felixd1900/TPSensor/Receiver/PCB_Full/Assembly/TPSensor-BOM.csv

Comment | Designator | Footprint | LCSC
100nF | C1 | Capacitor_SMD:C_0402_1005Metric | C1525
100nF | C2 | Capacitor_SMD:C_0402_1005Metric | C1525
100nF | C3 | Capacitor_SMD:C_0402_1005Metric | C1525
100nF | C4 | Capacitor_SMD:C_0402_1005Metric | C1525
10uF | C5 | Capacitor_SMD:C_1206_3216Metric | C13585
100nF | C6 | Capacitor_SMD:C_0402_1005Metric | C1525
100nF | C7 | Capacitor_SMD:C_0402_1005Metric | C1525
100nF | C8 | Capacitor_SMD:C_0402_1005Metric | C1525
1uF | C9 | Capacitor_SMD:C_0402_1005Metric | C52923
10pF | C10 | Capacitor_SMD:C_0402_1005Metric | C32949
10pF | C11 | Capacitor_SMD:C_0402_1005Metric | C32949
100nF | C12 | Capacitor_SMD:C_0402_1005Metric | C1525
22uF | C13 | Capacitor_SMD:C_1206_3216Metric | C12891
100nF | C14 | Capacitor_SMD:C_0402_1005Metric | C1525
100nF | C15 | Capacitor_SMD:C_0402_1005Metric | C1525
10uF | C16 | Capacitor_SMD:C_1206_3216Metric | C13585
1uF | C17 | Capacitor_SMD:C_0402_1005Metric | C52923
100nF | C18 | Capacitor_SMD:C_0402_1005Metric | C1525
100nF | C19 | Capacitor_SMD:C_0402_1005Metric | C1525
22uF | C20 | Capacitor_SMD:C_1206_3216Metric | C12891
100nF | C51 | Capacitor_SMD:C_0402_1005Metric | C1525
10pF | C81 | Capacitor_SMD:C_0402_1005Metric | C32949
10pF | C101 | Capacitor_SMD:C_0402_1005Metric | C32949
3.9pF | C121 | Capacitor_SMD:C_0402_1005Metric | C1566
8.2pF | C122 | Capacitor_SMD:C_0402_1005Metric | C1579
5.6pF | C123 | Capacitor_SMD:C_0402_1005Metric | C1574
220pF | C124 | Capacitor_SMD:C_0402_1005Metric | C1530
220pF | C125 | Capacitor_SMD:C_0402_1005Metric | C1530
3.9pF | C131 | Capacitor_SMD:C_0402_1005Metric | C1566
LED | D1 | LED_SMD:LED_0603_1608Metric | C2286
LED | D2 | LED_SMD:LED_0603_1608Metric | C2286
SWD_Connector | J1 | Connector_PinHeader_1.27mm:PinHeader_2x05_P1.27mm_Vertical
USB_B_Micro | J2 | Connector_USB:USB_Micro-B_Molex-105017-0001 | C136000
Conn_01x03 (Boot Jumper) | J4 | Connector_PinHeader_2.54mm:PinHeader_1x03_P2.54mm_Vertical
SPI_Conn_01x04 (SPI) | J6 | Connector_PinHeader_2.54mm:PinHeader_1x04_P2.54mm_Vertical
Conn_01x03 (Power Jumper) | J7 | Connector_PinHeader_2.54mm:PinHeader_1x03_P2.54mm_Vertical
Screw_Terminal_01x02 (3.3V) | J8 | TerminalBlock_Phoenix:TerminalBlock_Phoenix_MKDS-3-2-5.08_1x02_P5.08mm_Horizontal
Conn_Coaxial | J9 | Connector_Coaxial:SMA_Amphenol_901-143_Horizontal | C496551
ABP2Conn_01x05 | J10 | Connector_PinHeader_2.54mm:PinHeader_1x05_P2.54mm_Vertical
39nH | L2 | Inductor_SMD:L_0402_1005Metric | C26443
27nH | L121 | Inductor_SMD:L_0402_1005Metric | C18830
22nH | L122 | Inductor_SMD:L_0402_1005Metric | C86129
27nH | L123 | Inductor_SMD:L_0402_1005Metric | C18830
27nH | L131 | Inductor_SMD:L_0402_1005Metric | C18830
10k | R2 | Resistor_SMD:R_0402_1005Metric | C25744
47 | R3 | Resistor_SMD:R_0603_1608Metric | C23182
680 | R4 | Resistor_SMD:R_0603_1608Metric | C23228
47 | R6 | Resistor_SMD:R_0603_1608Metric | C23182
680 | R7 | Resistor_SMD:R_0603_1608Metric | C23228
10k | R8 | Resistor_SMD:R_0402_1005Metric | C25744
10k | R9 | Resistor_SMD:R_0402_1005Metric | C25744
56k | R171 | Resistor_SMD:R_0603_1608Metric | C23206
USBLC6-2SC6 | U1 | Package_TO_SOT_SMD:SOT-23-6 | C7519
CC1101RGPR | U3 | CC1101RGPR:RGP20_2P4X2P4 | C29953
STM32L052C8Tx | U4 | Package_QFP:LQFP-48_7x7mm_P0.5mm | C111213
AMS1117-3.3 | U5 | Package_TO_SOT_SMD:SOT-223 | C347222
26MHz | Y1 | Crystal:Crystal_SMD_3225-4Pin_3.2x2.5mm | C15192
16MHz | Y2 | Crystal:Crystal_SMD_3225-4Pin_3.2x2.5mm | C13738
