felixd1900/TPSensor/General/Pinout_Debug.xlsx

gnd | schwarz
swclk | blau
rst | weiss
swdio | grün
3.3v | rot
swo | gelb
