felixd1900/TPSensor/Receiver/PCB_Full/Schematic.pdf

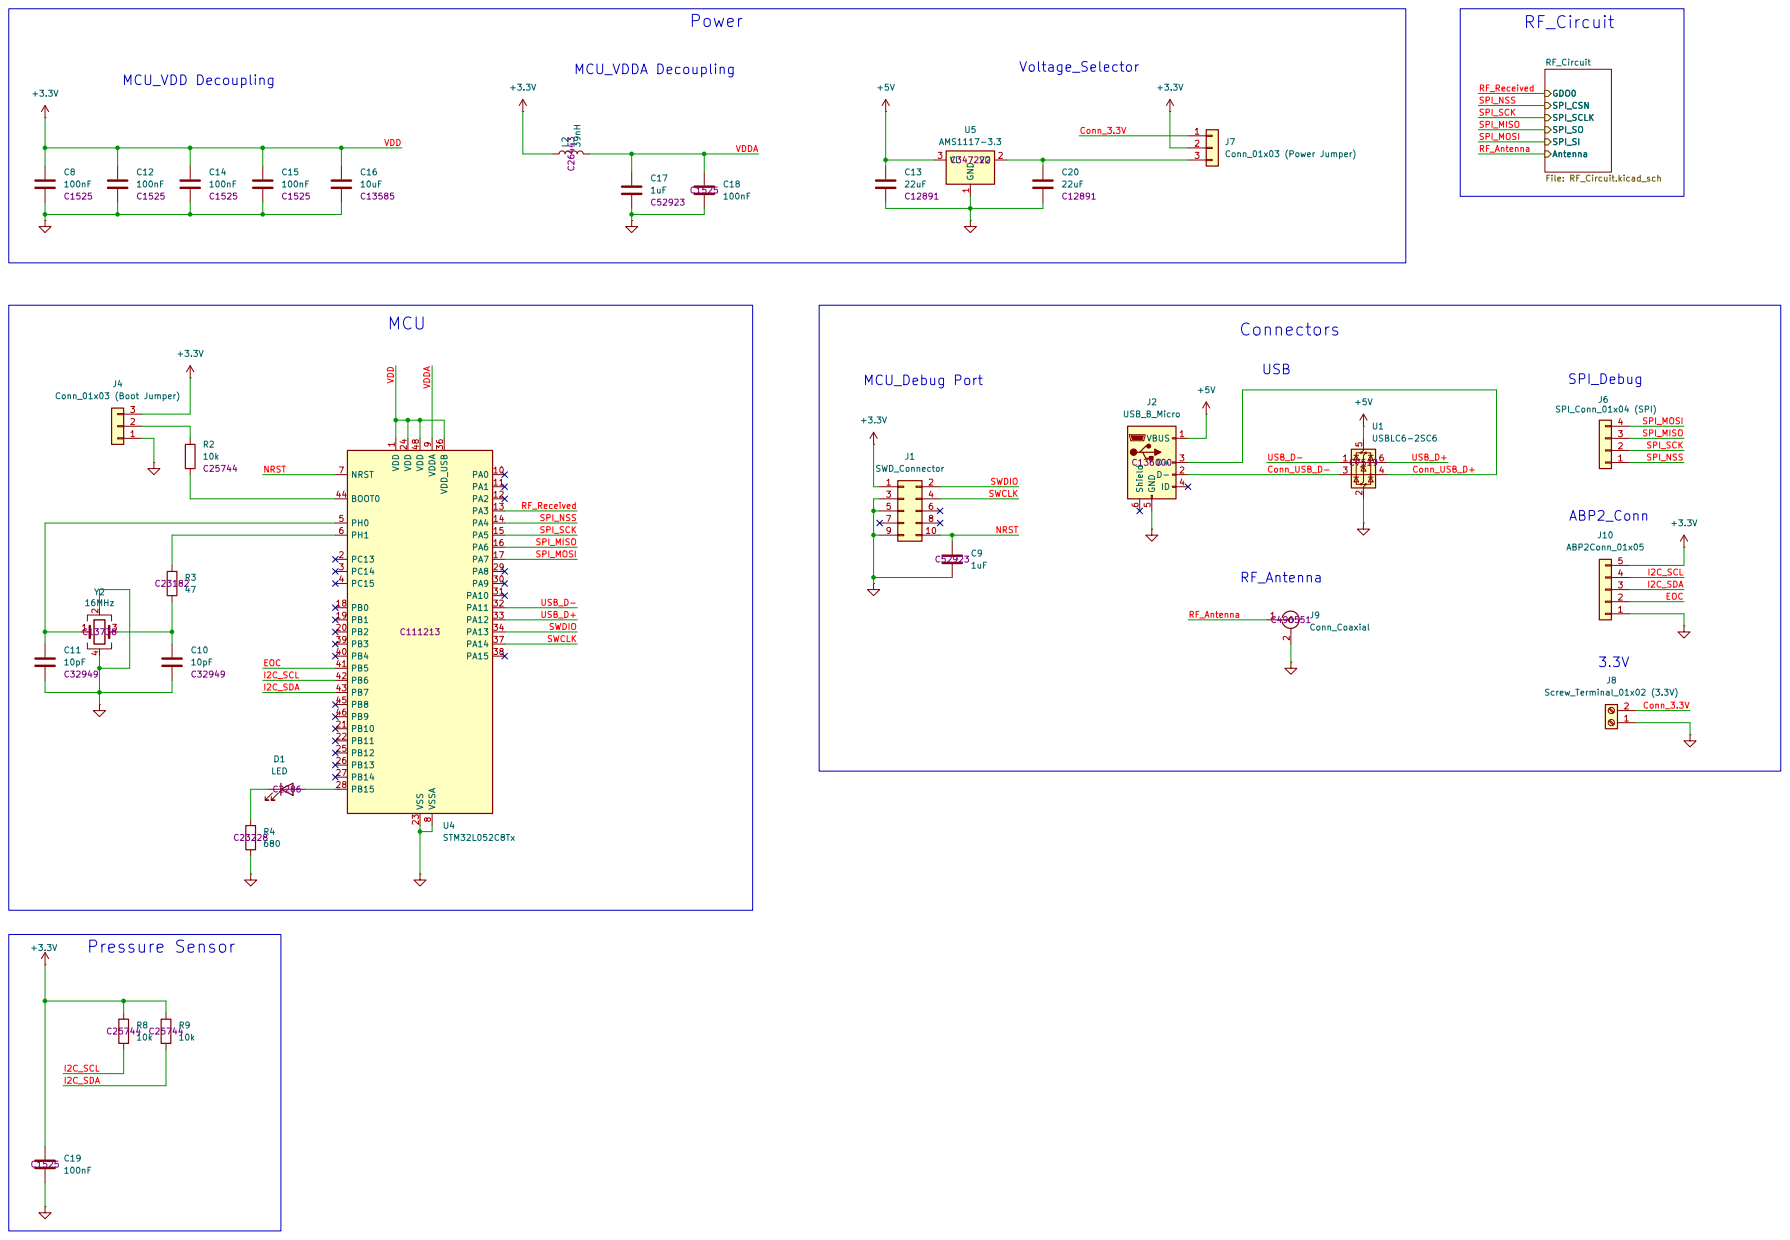
[picture p1: page 1]

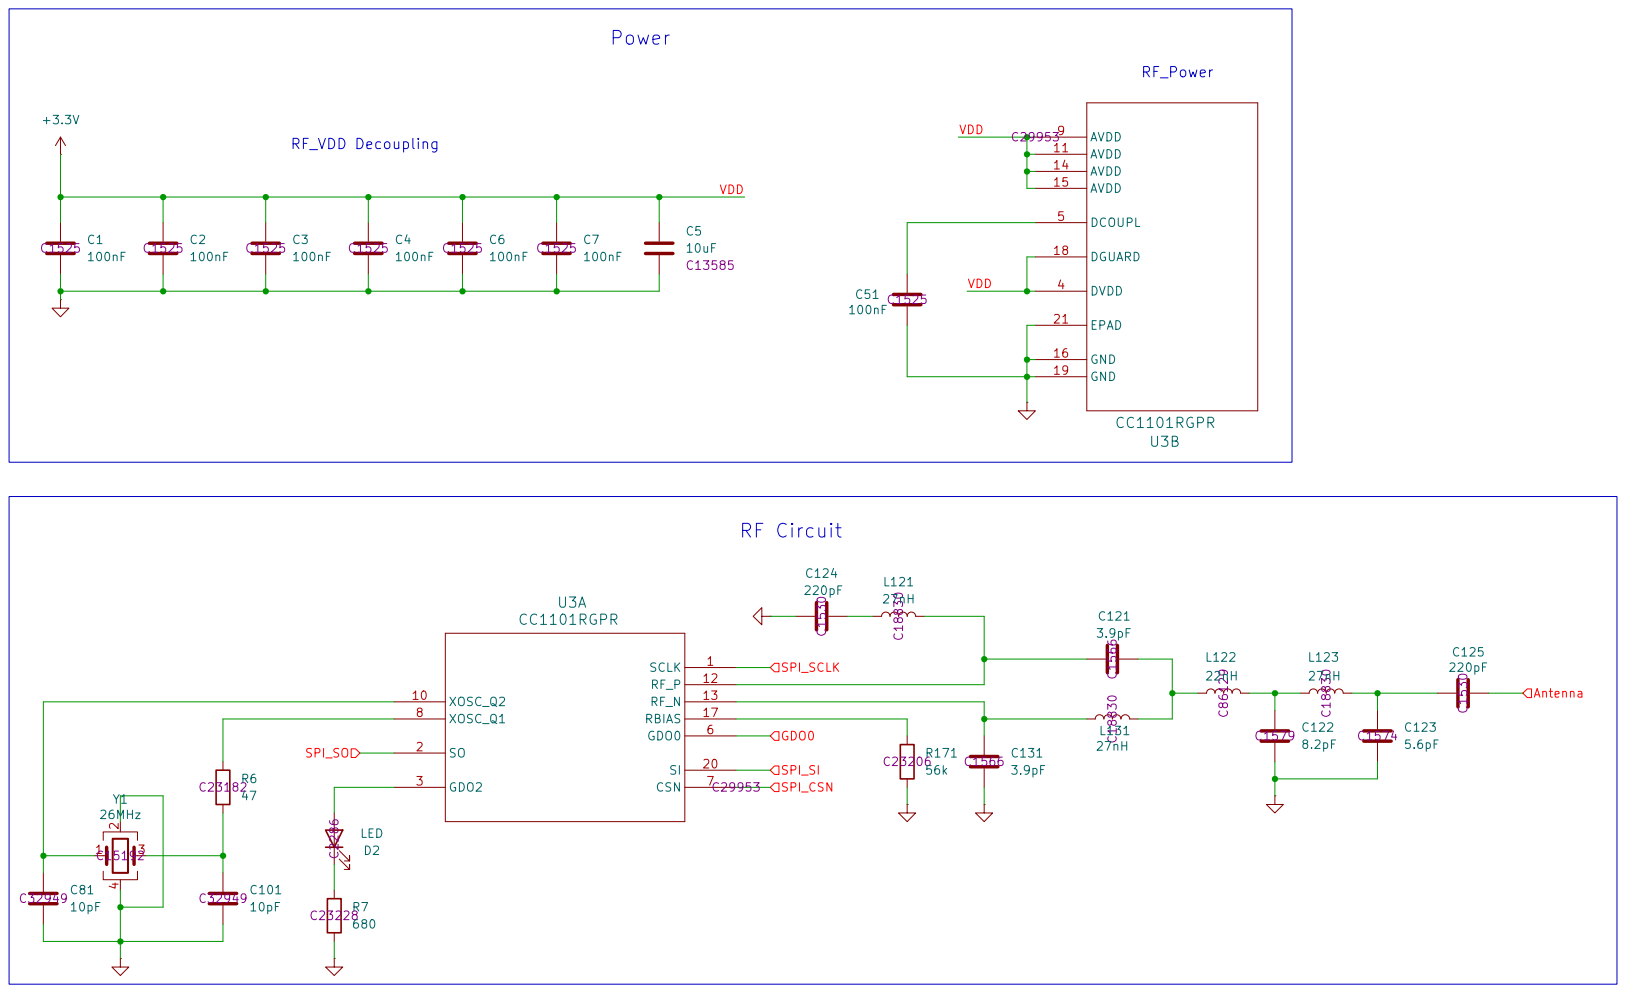
[picture p2: page 2]
