felixd1900/TPSensor/Receiver/PCB_Full/Receiver.kicad_pcb

## KiCad design Receiver/PCB_Full/Receiver.kicad_pcb (2025-09-05)

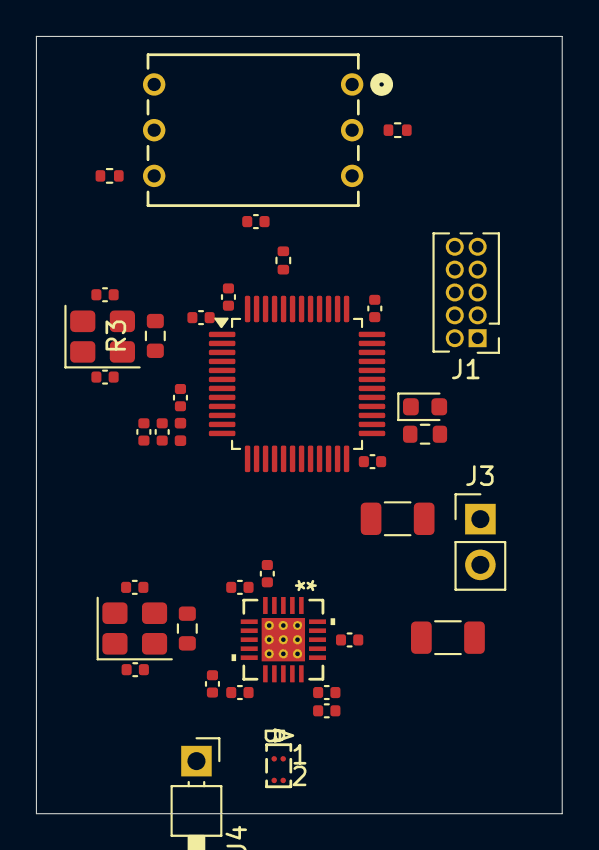
[picture p3: board Receiver.kicad_pcb from above]

Board: 4 copper layers, 29.2 x 43.2 mm, 38 parts (0 on the bottom side), 27 nets, no tracks yet.

Parts:
C1, C2, C3, C4, C6, C7, C8, C12, C14, C15, C18, C19, C51: 100nF; C_0402_1005Metric
C5, C16: 10uF; C_1206_3216Metric
C9, C17: 1uF; C_0402_1005Metric
C10, C11, C81, C101: 10pF; C_0402_1005Metric
D1: LED; LED_0603_1608Metric
J1: SWD_Connector; PinHeader_2x05_P1.27mm_Vertical
J3: Power_Connector; PinHeader_1x02_P2.54mm_Vertical
J4: Antenna_Connector; PinHeader_1x01_P2.54mm_Horizontal
L2: 39nH; L_0402_1005Metric
R2, R8, R9: 10k; R_0402_1005Metric
R3, R6: 47; R_0603_1608Metric
R4: 680; R_0603_1608Metric
U2: BAL-CC1101-01D3; BGA_01-01D3_STM
U3: CC1101RGPR; RGP20_2P4X2P4
U4: STM32L052C8Tx; LQFP-48_7x7mm_P0.5mm
U6: ABP2DANT001PG2A3XX; ABP2DANT&slash_G_HNW
Y1: 26MHz; Crystal_SMD_3225-4Pin_3.2x2.5mm
Y2: 16MHz; Crystal_SMD_3225-4Pin_3.2x2.5mm

Connections:
+3.3V: C1.1, C2.1, C3.1, C4.1, C5.1, C6.1, C7.1, C8.1, C12.1, C14.1, C15.1, C16.1, C19.1, J1.1, J3.2, L2.1, R8.1, R9.1, U3.4 (DVDD), U3.9 (AVDD), U3.11 (AVDD), U3.14 (AVDD), U3.15 (AVDD), U3.18 (DGUARD), U4.1 (VDD), U4.24 (VDD), U4.36 (VDD_USB), U4.48 (VDD), U6.1 (VDD)
/EOC: U4.41 (PB5), U6.3 (EOC)
/I2C_SCL: R8.2, U4.42 (PB6), U6.2 (SCL)
/I2C_SDA: R9.2, U4.43 (PB7), U6.4 (SDA)
/NRST: C9.1, J1.10, U4.7 (NRST)
/RF_Antenna: J4.1, U2.A1 (SE)
/RF_Received: U3.6 (GDO0), U4.13 (PA3)
/SPI_MISO: U3.2 (SO), U4.16 (PA6)
/SPI_MOSI: U3.20 (SI), U4.17 (PA7)
/SPI_NSS: U3.7 (CSN), U4.14 (PA4)
/SPI_SCK: U3.1 (SCLK), U4.15 (PA5)
/SWCLK: J1.4, U4.37 (PA14)
/SWDIO: J1.2, U4.34 (PA13)
/VDDA: C17.1, C18.1, L2.2, U4.9 (VDDA)
GND: C1.2, C2.2, C3.2, C4.2, C5.2, C6.2, C7.2, C8.2, C9.2, C10.2, C11.2, C12.2, C14.2, C15.2, C16.2, C17.2, C18.2, C19.2, C51.2, C81.2, C101.2, J1.3, J1.5, J1.9, J3.1, R2.2, R4.2, U2.B1 (GND), U3.16 (GND), U3.19 (GND), U3.21 (EPAD), U4.8 (VSSA), U4.23 (VSS), U4.35 (VSS), U4.47 (VSS), U6.5 (GND), Y1.2, Y1.4, Y2.2, Y2.4
unnamed: C10.1, R3.2, Y2.3
unnamed: C101.1, R6.2, Y1.3
unnamed: D1.2 (A), U4.28 (PB15)
unnamed: D1.1 (K), R4.1
unnamed: U2.A2 (DIFF), U3.13 (RF_N)
unnamed: U2.B2 (DIFF), U3.12 (RF_P)
unnamed: R6.1, U3.8 (XOSC_Q1)
unnamed: C81.1, U3.10 (XOSC_Q2), Y1.1
unnamed: C51.1, U3.5 (DCOUPL)
unnamed: R2.1, U4.44 (BOOT0)
unnamed: C11.1, U4.5 (PH0), Y2.1
unnamed: R3.1, U4.6 (PH1)
