felixd1900/TPSensor/TyrePressure/PCB_Dev/TPSensor.kicad_pcb

## KiCad design TyrePressure/PCB_Dev/TPSensor.kicad_pcb (2025-08-05)

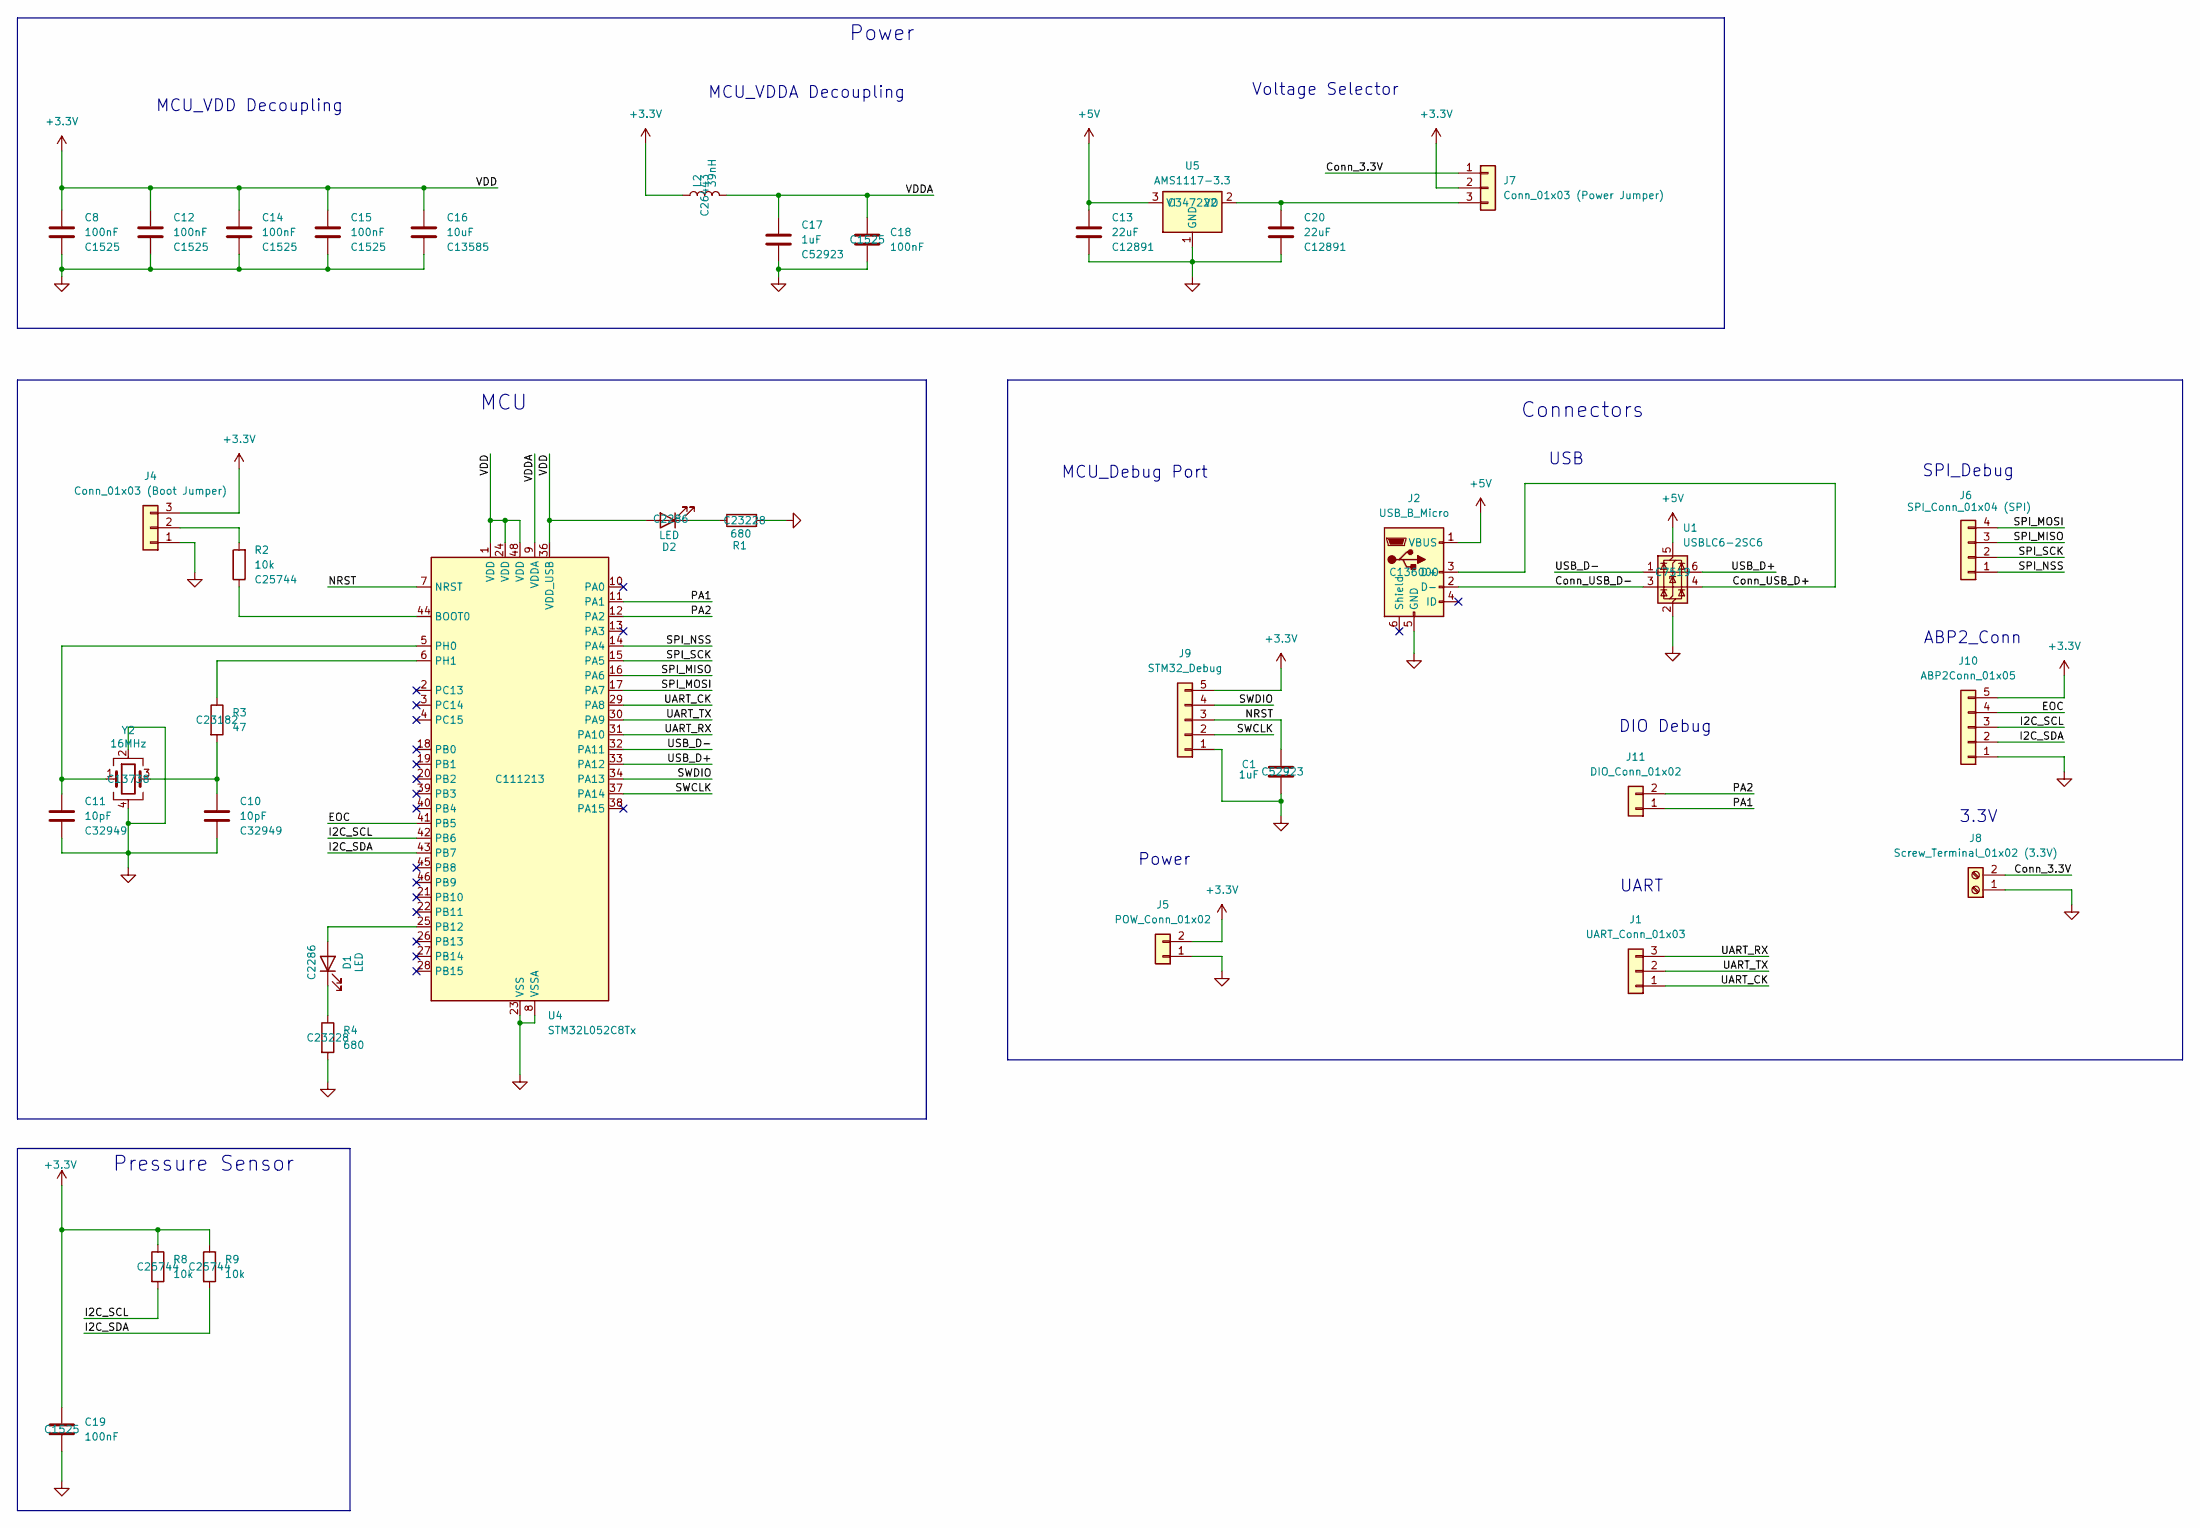
[picture p4: schematic TPSensor.kicad_sch]

Parts:
C1, C17: 1uF; C_0402_1005Metric; LCSC C52923
C8, C12, C14, C15, C18, C19: 100nF; C_0402_1005Metric; LCSC C1525
C10, C11: 10pF; C_0402_1005Metric; LCSC C32949
C13, C20: 22uF; C_1206_3216Metric; LCSC C12891
C16: 10uF; C_1206_3216Metric; LCSC C13585
D1, D2: LED; LED_0603_1608Metric; LCSC C2286
J1: UART_Conn_01x03; PinHeader_1x03_P2.54mm_Vertical
J2: USB_B_Micro; USB_Micro-B_Molex-105017-0001; LCSC C136000
J4: Conn_01x03 (Boot Jumper); PinHeader_1x03_P2.54mm_Vertical
J5: POW_Conn_01x02; PinHeader_1x02_P2.54mm_Vertical
J6: SPI_Conn_01x04 (SPI); PinHeader_1x04_P2.54mm_Vertical
J7: Conn_01x03 (Power Jumper); PinHeader_1x03_P2.54mm_Vertical
J8: Screw_Terminal_01x02 (3.3V); TerminalBlock_Phoenix_MKDS-3-2-5.08_1x02_P5.08mm_Horizontal
J9: STM32_Debug; PinHeader_1x05_P2.54mm_Vertical
J10: ABP2Conn_01x05; PinHeader_1x05_P2.54mm_Vertical
J11: DIO_Conn_01x02; PinHeader_1x02_P2.54mm_Vertical
L2: 39nH; L_0402_1005Metric; LCSC C26443
R1, R4: 680; R_0603_1608Metric; LCSC C23228
R2, R8, R9: 10k; R_0402_1005Metric; LCSC C25744
R3: 47; R_0603_1608Metric; LCSC C23182
U1: USBLC6-2SC6; SOT-23-6; LCSC C7519
U4: STM32L052C8Tx; LQFP-48_7x7mm_P0.5mm; LCSC C111213
U5: AMS1117-3.3; SOT-223; LCSC C347222
Y2: 16MHz; Crystal_SMD_3225-4Pin_3.2x2.5mm; LCSC C13738

Connections:
+3.3V: C8.1, C12.1, C14.1, C15.1, C16.1, C19.1, D2.2 (A), J4.3, J5.2, J7.2, J9.5, J10.5, L2.1, R8.1, R9.1, U4.1 (VDD), U4.24 (VDD), U4.36 (VDD_USB), U4.48 (VDD)
+5V: C13.1, J2.1 (VBUS), U1.5 (VBUS), U5.3 (VI)
/Conn_3.3V: J7.1, J8.2
/Conn_USB_D+: J2.3 (D+), U1.4 (I/O2)
/Conn_USB_D-: J2.2 (D-), U1.3 (I/O2)
/EOC: J10.4, U4.41 (PB5)
/I2C_SCL: J10.3, R8.2, U4.42 (PB6)
/I2C_SDA: J10.2, R9.2, U4.43 (PB7)
/NRST: C1.1, J9.3, U4.7 (NRST)
/PA1: J11.1, U4.11 (PA1)
/PA2: J11.2, U4.12 (PA2)
/SPI_MISO: J6.3, U4.16 (PA6)
/SPI_MOSI: J6.4, U4.17 (PA7)
/SPI_NSS: J6.1, U4.14 (PA4)
/SPI_SCK: J6.2, U4.15 (PA5)
/SWCLK: J9.2, U4.37 (PA14)
/SWDIO: J9.4, U4.34 (PA13)
/UART_CK: J1.1, U4.29 (PA8)
/UART_RX: J1.3, U4.31 (PA10)
/UART_TX: J1.2, U4.30 (PA9)
/USB_D+: U1.6 (I/O1), U4.33 (PA12)
/USB_D-: U1.1 (I/O1), U4.32 (PA11)
/VDDA: C17.1, C18.1, L2.2, U4.9 (VDDA)
GND: C1.2, C8.2, C10.2, C11.2, C12.2, C13.2, C14.2, C15.2, C16.2, C17.2, C18.2, C19.2, C20.2, J2.5 (GND), J4.1, J5.1, J8.1, J9.1, J10.1, R1.2, R4.2, U1.2 (GND), U4.8 (VSSA), U4.23 (VSS), U4.35 (VSS), U4.47 (VSS), U5.1 (GND), Y2.2, Y2.4
unnamed: C10.1, R3.2, Y2.3
unnamed: D1.2 (A), U4.25 (PB12)
unnamed: D1.1 (K), R4.1
unnamed: D2.1 (K), R1.1
unnamed: J4.2, R2.2
unnamed: C20.1, J7.3, U5.2 (VO)
unnamed: R2.1, U4.44 (BOOT0)
unnamed: C11.1, U4.5 (PH0), Y2.1
unnamed: R3.1, U4.6 (PH1)

Notes on the sheet:
3.3V
MCU_VDDA Decoupling
ABP2_Conn
UART
DIO Debug
Voltage Selector
SPI_Debug
MCU_VDD Decoupling
Power
MCU
Pressure Sensor
Connectors
USB
MCU_Debug Port

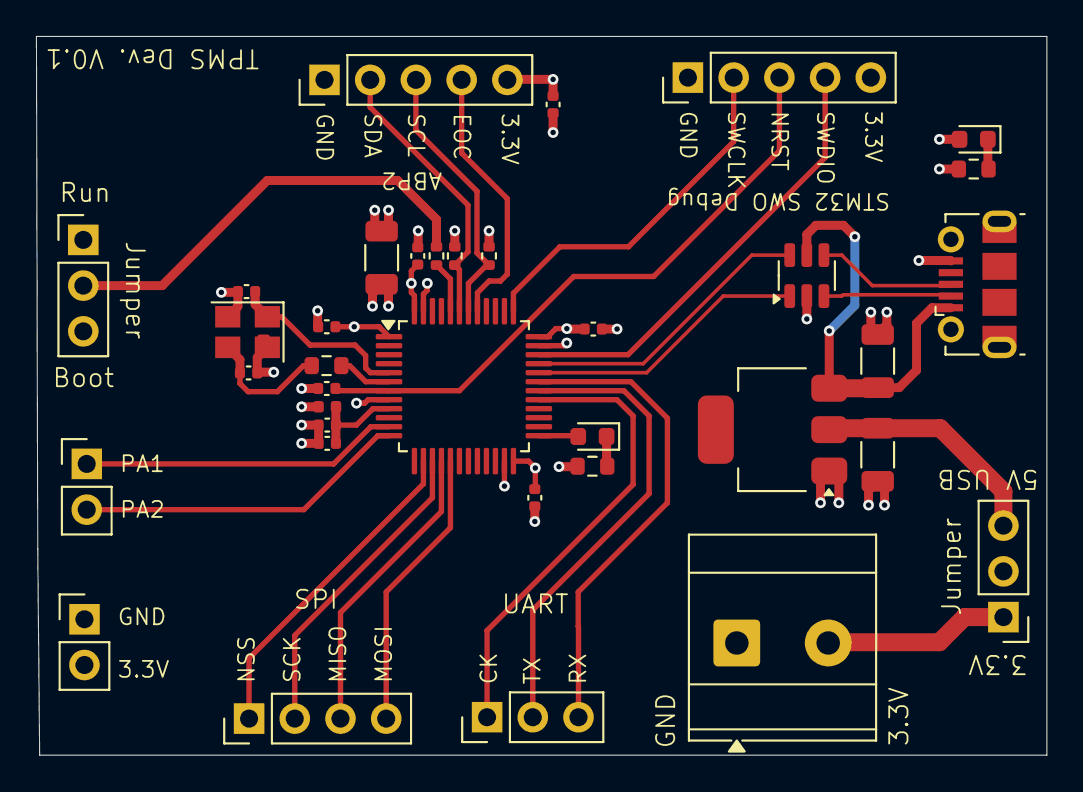
[picture p5: board TPSensor.kicad_pcb from above]

Board: 4 copper layers, 56.1 x 39.9 mm, 36 parts (0 on the bottom side), 33 nets.
