felixd1900/TPSensor/TyrePressure/Software/TPSensor/Core/Src/main.c

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
/* Includes ------------------------------------------------------------------*/
#include "main.h"

/* USER CODE BEGIN Includes */
#include "string.h"
#include "math.h"
#include "type_conv.h"
#include "abp2.h"
#include "cc1101.h"
/* USER CODE END Includes */

/* USER CODE BEGIN PTD */

//address offset in eeprom
typedef enum {
	// U8 Values
	EE_ADDR_SENSOR_ID = 			0x00,
	EE_ADDR_SENSOR_TYPE = 			0x01,
	// U32 Values
	EE_ADDR_STORAGE_SAMPLE =		0x10,
	EE_ADDR_TRANS_SAMPLE =			0x14,
	EE_ADDR_TRANS_TX =				0x18,
	EE_ADDR_STATIC_SAMPLE =			0x1C,
	EE_ADDR_STATIC_TX =				0x20,
	// float
	EE_ADDR_THRESH1 =				0x30,
	EE_ADDR_THRESH2 =				0x34,
	EE_ADDR_CHANGE =				0x38
}ee_offset_t;

typedef enum {
	PRO_MODE_OPERATION = 		0x01,
	PRO_MODE_PROGRAMMING = 		0x02
} pro_mode_t;

typedef enum {
	PRO_CMD_SENSOR_ID = 				0x01,
	PRO_CMD_SENSOR_TYPE = 				0x02,
	PRO_CMD_STORAGE_SAMPLE = 			0x10,
	PRO_CMD_TRANS_SAMPLE = 				0x11,
	PRO_CMD_TRANS_TX = 					0x12,
	PRO_CMD_STATIC_SAMPLE = 			0x13,
	PRO_CMD_STATIC_TX = 				0x14,
	PRO_CMD_PRESS_THRESH1 = 			0x20,
	PRO_CMD_PRESS_THRESH2 = 			0x21,
	PRO_CMD_PRESS_THRESH_CHANGE = 		0x22,
	PRO_CMD_READ_ALL =					0x50
} pro_cmd_t;

typedef enum {
	OP_MODE_STORAGE = 			0x01,
	OP_MODE_TRANSIENT = 		0x02,
	OP_MODE_STATIC =			0x03
} op_mode_t;

typedef struct {
	uint8_t sensorid;						//this is the default sensorid the current id is stored in eeprom
	uint8_t sensortype;						//0x01 = tyre pressure | 0x02 = brake disk pressure (to be implemented)
	uint32_t storage_time_sample;			//sample rate tx (ms) in transient mode
	uint32_t trans_time_tx;					//sample rate tx (ms) in transient mode
	uint32_t trans_time_sample;				//sample rate abp2 read (ms) in transient mode
	uint32_t static_time_tx;				//sample rate tx (ms) in transient mode
	uint32_t static_time_sample;			//sample rate abp2 read (ms) in transient mode
	float trans_press_thresh1;				//move from storage into transient mode
	float trans_press_thresh2;				//move from transient mode into storage mode
	float trans_press_change;				//minimum pressure change to move to transient mode
}eeprom_conf_t;


typedef struct {
    float y;            // filtered value
    float alpha;        // smaller value -> more smoothing
} ema_t;


/* USER CODE END PTD */

/* USER CODE BEGIN PD */

#define ABP2_I2C_ID				0x28
#define TX_FIFO_EEPROM_LEN		36
#define TX_FIFO_DATA_LEN		14
#define RX_FIFO_EEPROM_LEN		7		// cmd, uint32 data, lqi, rssi
#define RESPONSE_DELAY 			100		// delay in ms when responding to request (wait for other CC1101 to settle in RX)

/* USER CODE END PD */

I2C_HandleTypeDef hi2c1;

RTC_HandleTypeDef hrtc;

SPI_HandleTypeDef hspi1;

TIM_HandleTypeDef htim21;
TIM_HandleTypeDef htim22;

/* USER CODE BEGIN PV */

//===========Programmable variables========
eeprom_conf_t eeprom_conf = {
    .sensorid            = 0x10,
    .sensortype          = 0x01,   // 0x01 = tyre pressure
    .storage_time_sample = 5000,
    .trans_time_tx       = 1000,
    .trans_time_sample   = 100,
    .static_time_tx      = 10000,
    .static_time_sample  = 100,
    .trans_press_thresh1 = 0.6f,
    .trans_press_thresh2 = 0.5f,
    .trans_press_change  = 0.0f,
};

//==============Gereral variables==========
pro_mode_t programming_mode = PRO_MODE_OPERATION;
op_mode_t operational_mode = OP_MODE_TRANSIENT;
op_mode_t operational_mode_old = OP_MODE_TRANSIENT;
bool pro_mode_changed = false;
bool op_mode_changed = false;
ema_t ema_pressure = {0, 0.5};
ema_t ema_temperature = {20, 0.5};

//==============ABP2 Variables=============
abp2_t abp2;
float abp2_pressure = 0.0f;
float abp2_pressure_change = 0.0f;
float abp2_temperature = 0.0f;
abp2_status abp2status;
uint8_t abp2status_raw = 0;
bool abp2_sample_ready = false;
uint32_t abp2_sample_timer = 100;


//============CC1101 TX Variables==========
cc1101_t cc1101;
uint8_t tx_fifo_eeprom[TX_FIFO_EEPROM_LEN] = {};
uint8_t tx_fifo_data[TX_FIFO_DATA_LEN] = {};
uint8_t debug_tx_counter = 0;
cc1101_marc_state marcstate = CC1101_MARC_SLEEP;
bool Init_complete = false;
uint32_t tx_duration = 0;
bool tx_ready = false;
uint32_t tx_timer = 1000;


//============CC1101 RX variables==========
uint8_t rx_bytes = 0x00;
uint8_t rx[RX_FIFO_EEPROM_LEN] = {0};
bool rx_received = false;
uint8_t rx_length = 0x00;

//=============Debug variables=============
uint8_t debug_status_part = 0;
uint8_t debug_status_ver = 0;
uint8_t debug_reg_all_before[46] = {0};
uint8_t debug_reg_all_after[46] = {0};
cc1101_tx_power cc1101_power_ramp[8] = {CC1101_TX_M30dB, CC1101_TX_M20dB, CC1101_TX_M15dB, CC1101_TX_M10dB, CC1101_TX_0dB, CC1101_TX_5dB, CC1101_TX_7dB, CC1101_TX_10dB};
//cc1101_tx_power cc1101_power_ramp[1] = {CC1101_TX_10dB};
uint32_t debug_timer_tick = 0;
uint32_t debug_time_ms = 0;

pro_cmd_t debug_pro_cmd;
uint8_t debug_cmd_data[4] = {0};
uint8_t debug_rx_counter = 0;
uint8_t debug_pktstatus = 0x00;

uint8_t debug_tx_bytes1 = 0xFF;
uint8_t debug_tx_bytes2 = 0xFF;

/* USER CODE END PV */

void SystemClock_Config(void);
static void MX_GPIO_Init(void);
static void MX_I2C1_Init(void);
static void MX_SPI1_Init(void);
static void MX_RTC_Init(void);
static void MX_TIM21_Init(void);
static void MX_TIM22_Init(void);
/* USER CODE BEGIN PFP */

static void Settings_LoadOrInit(bool firstcall, eeprom_conf_t *e);


static float ema_push(ema_t *f, float val);
static void ema_set_alpha(ema_t *f, float dt_s, float tau_s);

static void SetTimer(TIM_HandleTypeDef *htim, uint32_t timer_ms);
static void DeepSleep(uint32_t timer_s);

static void Send_Data(eeprom_conf_t e, float pressure, float temperature);
static void Send_EEPROM(eeprom_conf_t e);
static void Read_Programming_CMD(void);
static void Write_Programming(uint8_t *buf, eeprom_conf_t *e);

static void Select_Mode(void);
static void CreateTx_DataFrame(uint8_t *frame, uint8_t power, eeprom_conf_t e, float pressure, float temperature);
static void CreateTx_EEPROMFrame(uint8_t *frame, uint8_t power, eeprom_conf_t e);


/* USER CODE END PFP */

/* USER CODE BEGIN 0 */

void HAL_GPIO_EXTI_Callback(uint16_t GPIO_Pin)
{
	if (Init_complete)
	{
		if (GPIO_Pin == RX_TX_SW_IRQ_Pin)
		{
			Select_Mode();
		}

		else if (GPIO_Pin == RX_IRQ_Pin)
		{
			rx_received = true;
		}
	}
}

void HAL_RTCEx_WakeUpTimerEventCallback(RTC_HandleTypeDef *hrtc)
{
	abp2_sample_ready = true;      // nur Flag setzen
}

void HAL_TIM_PeriodElapsedCallback(TIM_HandleTypeDef *htim)
{
    if (htim == &htim21) {
        abp2_sample_ready = true;      // nur Flag setzen
    }
    else if (htim == &htim22)
    {
    	tx_ready = true;
    }
}

/* USER CODE END 0 */

/**
  * @brief  The application entry point.
  * @retval int
  */
int main(void)
{

  /* MCU Configuration--------------------------------------------------------*/

  /* Reset of all peripherals, Initializes the Flash interface and the Systick. */
  HAL_Init();

  /* Configure the system clock */
  SystemClock_Config();

  /* Initialize all configured peripherals */
  MX_GPIO_Init();
  MX_I2C1_Init();
  MX_SPI1_Init();
  MX_RTC_Init();
  MX_TIM21_Init();
  MX_TIM22_Init();
  /* USER CODE BEGIN 2 */

  Settings_LoadOrInit(false, &eeprom_conf);		//true write first time to eeprom, flase read from eeprom

  //Start Timers
  HAL_TIM_Base_Start_IT(&htim21);
  HAL_TIM_Base_Start_IT(&htim22);

  // ABP2 Init (Address 0x28)
  ABP2_Init(&abp2, &hi2c1, ABP2_I2C_ID);

  // CC1101 Init
  CC1101_Init(&cc1101, &hspi1, SPI1_CS_GPIO_Port, SPI1_CS_Pin);

  // CC1101 Debugging tests
  CC1101_read_status(&cc1101, CC1101_STATUS_PARTNUM, &debug_status_part);
  CC1101_read_status(&cc1101, CC1101_STATUS_VERSION, &debug_status_ver);

  // CC1101 Configuration
  CC1101_read_register_burst(&cc1101, CC1101_REG_IOCFG2, debug_reg_all_before, 46);
  CC1101_Apply433_38k4(&cc1101);
  CC1101_read_register_burst(&cc1101, CC1101_REG_IOCFG2, debug_reg_all_after, 46);

  // CC1101 Prepare for tx/rx will be perfomed at start of main wile loop

  Init_complete = true;

  Select_Mode();		//init programming mode


  /* USER CODE END 2 */

  /* Infinite loop */
  /* USER CODE BEGIN WHILE */
  while (1)
  {
    /* USER CODE END WHILE */

    /* USER CODE BEGIN 3 */
	//==================================Programming Mode========================================
	if (pro_mode_changed)	//change rx/tx state depending on current mode (programming vs operational)
	{						//changing the mode directly in IRQ function is not adviced (because CC1101 mode might get stuck)
	    if (HAL_GPIO_ReadPin(RX_TX_SW_IRQ_GPIO_Port, RX_TX_SW_IRQ_Pin) == GPIO_PIN_SET)
	    {
	    	CC1101_EnterRx(&cc1101);
	    }
	    else
	    {
	    	CC1101_PrepareTx(&cc1101);
	    }
	    pro_mode_changed = false;
	}


	if (programming_mode == PRO_MODE_OPERATION)
	{


		//=================================Operating Mode============================================
		op_mode_changed = (operational_mode_old != operational_mode);
		operational_mode_old = operational_mode;
		abp2_pressure_change = 0;//fabs(abp2_pressure - ema_pressure.y);

		if (op_mode_changed)		// Only execute once if mode changes
		{
			switch (operational_mode)
			{
			case OP_MODE_STORAGE:
				ema_set_alpha(&ema_pressure, eeprom_conf.storage_time_sample, eeprom_conf.storage_time_sample);		//set alpha
				// In deployment go to deep sleep and stop timers
				SetTimer(&htim21, eeprom_conf.storage_time_sample);													//Set Timer for Sample Speed
				SetTimer(&htim22, eeprom_conf.static_time_tx);														//Set Timer for TX Speed
				break;

			case OP_MODE_TRANSIENT:
				ema_set_alpha(&ema_pressure, eeprom_conf.trans_time_sample, eeprom_conf.trans_time_tx);				//set alpha
				SetTimer(&htim21, eeprom_conf.trans_time_sample);													//Set Timer for Sample Speed
				SetTimer(&htim22, eeprom_conf.trans_time_tx);														//Set Timer for TX Speed
				break;

			case OP_MODE_STATIC:
				ema_set_alpha(&ema_pressure, eeprom_conf.static_time_sample, eeprom_conf.static_time_tx);			//set alpha
				SetTimer(&htim21, eeprom_conf.static_time_sample);													//Set Timer for Sample Speed
				SetTimer(&htim22, eeprom_conf.static_time_tx);														//Set Timer for TX Speed
				break;
			}
		}


		switch (operational_mode)		// Execute perodically (induced by timer set above)
		{
		case OP_MODE_STORAGE:			// Operation Mode read sensor data & send data

			if (true)		// abp2_sample_ready
			{
				abp2status = ABP2_ReadAll(&abp2, &abp2_pressure, &abp2_temperature, &abp2status_raw);
				ema_push(&ema_pressure, abp2_pressure);
				//DeepSleep(5);
				HAL_Delay(2000);	//Remove with stop mode, and wake up with
				debug_timer_tick = __HAL_TIM_GET_COUNTER(&htim21);
			}

			// Condition change
			if (abp2_pressure > eeprom_conf.trans_press_thresh1)
			{
				if (abp2_pressure_change > eeprom_conf.trans_press_change)
				{
					operational_mode = OP_MODE_TRANSIENT;
				}
				else
				{
					operational_mode = OP_MODE_STATIC;
				}
			}
			break;

		case OP_MODE_TRANSIENT:

			if (abp2_sample_ready)
			{
				abp2status = ABP2_ReadAll(&abp2, &abp2_pressure, &abp2_temperature, &abp2status_raw);
				ema_push(&ema_pressure, abp2_pressure);
				abp2_sample_ready = false;
				//start new timer
			}

			if (tx_ready)
			{
				CC1101_PrepareTx(&cc1101);
				Send_Data(eeprom_conf, ema_pressure.y, ema_temperature.y);
				CC1101_EnterSleep(&cc1101);
				tx_ready = false;
			}

			//Condition change
			if (abp2_pressure_change > eeprom_conf.trans_press_change)
			{
				operational_mode = OP_MODE_TRANSIENT;
			}
			else if (abp2_pressure < eeprom_conf.trans_press_thresh2)
			{
				operational_mode = OP_MODE_STORAGE;
			}
			break;


		case OP_MODE_STATIC:

			if (abp2_sample_ready)
			{
				abp2status = ABP2_ReadAll(&abp2, &abp2_pressure, &abp2_temperature, &abp2status_raw);
				abp2_sample_ready = false;
			}

			if (tx_ready)
			{
				Send_Data(eeprom_conf, ema_pressure.y, ema_temperature.y);
				tx_ready = false;
			}

			//Condition change
			if (abp2_pressure_change > eeprom_conf.trans_press_change)
			{
				operational_mode = OP_MODE_TRANSIENT;
			}
			else if (abp2_pressure < eeprom_conf.trans_press_thresh2)
			{
				operational_mode = OP_MODE_STORAGE;
			}
			break;
		}
	}

	else if ((programming_mode == PRO_MODE_PROGRAMMING))
	{
		CC1101_read_marcstate(&cc1101, &marcstate);
		CC1101_read_status(&cc1101, CC1101_STATUS_RXBYTES, &rx_bytes);
		//receive programming data and write to eeprom and variables
		if (rx_received)
		{
			CC1101_read_status(&cc1101, CC1101_STATUS_PKTSTATUS, &debug_pktstatus);
			Read_Programming_CMD();
			rx_received = false;
		}
	}
  }
  /* USER CODE END 3 */
}

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
/* USER CODE BEGIN 4 */


static void Settings_LoadOrInit(bool firstcall, eeprom_conf_t *e)
{
    if (firstcall)
    {
        EE_WriteU8(EE_ADDR_SENSOR_ID, e->sensorid);
        EE_WriteU8(EE_ADDR_SENSOR_TYPE, e->sensortype);

        EE_WriteU32(EE_ADDR_STORAGE_SAMPLE, e->storage_time_sample);
        EE_WriteU32(EE_ADDR_TRANS_TX, e->trans_time_tx);
        EE_WriteU32(EE_ADDR_TRANS_SAMPLE, e->trans_time_sample);
        EE_WriteU32(EE_ADDR_STATIC_TX, e->static_time_tx);
        EE_WriteU32(EE_ADDR_STATIC_SAMPLE, e->static_time_sample);

        EE_WriteF32(EE_ADDR_THRESH1, e->trans_press_thresh1);
        EE_WriteF32(EE_ADDR_THRESH2, e->trans_press_thresh2);
        EE_WriteF32(EE_ADDR_CHANGE, e->trans_press_change);
    }
    else
    {
    	e->sensorid  = EE_ReadU8(EE_ADDR_SENSOR_ID);
    	e->sensortype = EE_ReadU8(EE_ADDR_SENSOR_TYPE);

    	e->storage_time_sample = EE_ReadU32(EE_ADDR_STORAGE_SAMPLE);
    	e->trans_time_tx = EE_ReadU32(EE_ADDR_TRANS_TX);
    	e->trans_time_sample = EE_ReadU32(EE_ADDR_TRANS_SAMPLE);
    	e->static_time_tx = EE_ReadU32(EE_ADDR_STATIC_TX);
    	e->static_time_sample = EE_ReadU32(EE_ADDR_STATIC_SAMPLE);

    	e->trans_press_thresh1 = EE_ReadF32(EE_ADDR_THRESH1);
    	e->trans_press_thresh2 = EE_ReadF32(EE_ADDR_THRESH2);
    	e->trans_press_change = EE_ReadF32(EE_ADDR_CHANGE);
    }
}

static void Write_Programming(uint8_t *buf, eeprom_conf_t *e)
{
	//length is byte 0
	pro_cmd_t cmd = buf[0];
	uint8_t *data = &buf[1];

	debug_pro_cmd = cmd;
	memcpy(debug_cmd_data, buf + 2, sizeof(debug_cmd_data));

	switch (cmd)
	{
	case PRO_CMD_SENSOR_ID:
		e->sensorid = data[0];
		EE_WriteU8(EE_ADDR_SENSOR_ID, e->sensorid);
		break;

	case PRO_CMD_SENSOR_TYPE:
		e->sensortype = data[0];
		EE_WriteU8(EE_ADDR_SENSOR_TYPE, e->sensortype);
		break;

	case PRO_CMD_STORAGE_SAMPLE:
		e->storage_time_sample = Bytearray_to_UINT32(data);
		EE_WriteU32(EE_ADDR_STORAGE_SAMPLE, e->storage_time_sample);
		break;

	case PRO_CMD_TRANS_TX:
		e->trans_time_tx = Bytearray_to_UINT32(data);
		EE_WriteU32(EE_ADDR_TRANS_TX, e->trans_time_tx);
		break;

	case PRO_CMD_TRANS_SAMPLE:
		e->trans_time_sample = Bytearray_to_UINT32(data);
		EE_WriteU32(EE_ADDR_TRANS_SAMPLE, e->trans_time_sample);
		break;

	case PRO_CMD_STATIC_TX:
		e->static_time_tx = Bytearray_to_UINT32(data);
		EE_WriteU32(EE_ADDR_STATIC_TX, e->static_time_tx);
		break;

	case PRO_CMD_STATIC_SAMPLE:
		e->static_time_sample = Bytearray_to_UINT32(data);
		EE_WriteU32(EE_ADDR_STATIC_SAMPLE, e->static_time_sample);
		break;

	case PRO_CMD_PRESS_THRESH1:
		e->trans_press_thresh1 = Bytearray_to_Float(data);
		EE_WriteF32(EE_ADDR_THRESH1, e->trans_press_thresh1);
		break;

	case PRO_CMD_PRESS_THRESH2:
		e->trans_press_thresh2 = Bytearray_to_Float(data);
		EE_WriteF32(EE_ADDR_THRESH2, e->trans_press_thresh2);
		break;

	case PRO_CMD_PRESS_THRESH_CHANGE:
		e->trans_press_change = Bytearray_to_Float(data);
		EE_WriteF32(EE_ADDR_CHANGE, e->trans_press_change);
		break;

	case PRO_CMD_READ_ALL:
		HAL_Delay(RESPONSE_DELAY);
		Send_EEPROM(eeprom_conf);
		break;
	}
}

//================================= EMA ====================================

static void ema_set_alpha(ema_t *f, float dt_s, float tau_s)
{
	//set correct alpha for selected filter period
    f->alpha = 1.0f - expf(-dt_s / tau_s);
}

static float ema_push(ema_t *f, float val) {
    f->y += f->alpha * (val - f->y);
    return f->y;
}


//================================= TIMER ====================================

static void SetTimer(TIM_HandleTypeDef *htim, uint32_t timer_ms)
{
	timer_ms = timer_ms - 1;

    __HAL_TIM_DISABLE(htim);                       				// Stop Timer
    __HAL_TIM_SET_AUTORELOAD(htim, timer_ms);          			// Set Timer period
    __HAL_TIM_SET_COUNTER(htim, 0);               				// zero counter
    __HAL_TIM_CLEAR_FLAG(htim, TIM_FLAG_UPDATE);  				// remove update flag
    HAL_TIM_GenerateEvent(htim, TIM_EVENTSOURCE_UPDATE); 		// latch psc
    __HAL_TIM_ENABLE(htim);                        				// Restart Timer
}

static void DeepSleep(uint32_t timer_s)
{
    HAL_RTCEx_DeactivateWakeUpTimer(&hrtc);
    HAL_RTCEx_SetWakeUpTimer_IT(&hrtc, timer_s, RTC_WAKEUPCLOCK_CK_SPRE_16BITS);
    HAL_SuspendTick();

    HAL_PWREx_EnableUltraLowPower();
    HAL_PWREx_EnableFastWakeUp();
    HAL_PWR_EnterSTOPMode(PWR_LOWPOWERREGULATOR_ON, PWR_STOPENTRY_WFI);

    SystemClock_Config();
    HAL_ResumeTick();
}

//================================= TX ====================================

static void Send_Data(eeprom_conf_t e, float pressure, float temperature)		//Variables are defined at start to be used for debugging
{
	//CC1101 Send with all power levels
	for(int i = 0; i < sizeof(cc1101_power_ramp); i++)
	{
		CC1101_Set_Tx_power(&cc1101, cc1101_power_ramp[i]);										//ramp tx power to test rssi
		CreateTx_DataFrame(tx_fifo_data, i, e, pressure, temperature);
		CC1101_write_TX_FIFO(&cc1101, tx_fifo_data, sizeof(tx_fifo_data));
		tx_duration = CC1101_SendTx(&cc1101);													//send time, depends on data rate
		HAL_Delay(100);																			//Added Delay for testing remove for deployment
	}
	// Status read out
	debug_tx_counter++;
	CC1101_read_marcstate(&cc1101, &marcstate);
}

static void Send_EEPROM(eeprom_conf_t e)
{
	//CC1101 Send with all power levels
	CC1101_PrepareTx(&cc1101);
	for(int i = 0; i < sizeof(cc1101_power_ramp); i++)
	{
		CC1101_Set_Tx_power(&cc1101, cc1101_power_ramp[i]);								//ramp tx power to test rssi
		CreateTx_EEPROMFrame(tx_fifo_eeprom, i, e);
		CC1101_write_TX_FIFO(&cc1101, tx_fifo_eeprom, sizeof(tx_fifo_eeprom));
		CC1101_read_status(&cc1101, CC1101_STATUS_TXBYTES, &debug_tx_bytes1);
		tx_duration = CC1101_SendTx(&cc1101);
		CC1101_read_status(&cc1101, CC1101_STATUS_TXBYTES, &debug_tx_bytes2);			//send time, depends on data rate
		HAL_Delay(50);																	//Added Delay for testing remove for deployment
	}
	// Status read out
	debug_tx_counter++;
	CC1101_EnterRx(&cc1101);
	CC1101_read_marcstate(&cc1101, &marcstate);
}

//================================= RX ====================================

static void Read_Programming_CMD(void)
{
	//CC1101 RX Status
	debug_rx_counter++;
    CC1101_read_marcstate(&cc1101, &marcstate);
    if (marcstate == CC1101_MARC_RXFIFO_OVERFLOW)						//Flush FIFO and wait for new message
    {
        CC1101_Recover_RX_Overflow(&cc1101);
        return;
    }

    CC1101_read_status(&cc1101, CC1101_STATUS_RXBYTES, &rx_bytes);

	if (rx_bytes > 0)
	{
		CC1101_read_RX_FIFO(&cc1101, &rx_length, 1);					//read packet length
		CC1101_read_status(&cc1101, CC1101_STATUS_RXBYTES, &rx_bytes);	//read again because byte was read from FIFO
		rx_length = rx_length + 2;										//add rssi and lqi

		if (rx_bytes == RX_FIFO_EEPROM_LEN)
		{
			//read current packet
			CC1101_read_RX_FIFO(&cc1101, rx, rx_bytes);
			Write_Programming(rx, &eeprom_conf);
			CC1101_EnterRx(&cc1101);
		}
		else
		{
			CC1101_EnterRx(&cc1101);	//flushing fifo in RX state is not possible, so flush in idle state
		}
	}
}

//================================= IRQ ====================================

static void Select_Mode(void)
{
    if (HAL_GPIO_ReadPin(RX_TX_SW_IRQ_GPIO_Port, RX_TX_SW_IRQ_Pin) == GPIO_PIN_SET)
    {
    	programming_mode = PRO_MODE_PROGRAMMING;
    }
    else
    {
    	programming_mode = PRO_MODE_OPERATION;
    }
		pro_mode_changed = true;		//will be reset to false in main loop due to not changin cc1101 state in between main  methods
}


//================================= FIFO ====================================

static void CreateTx_DataFrame(uint8_t *frame, uint8_t power, eeprom_conf_t e, float pressure, float temperature)
{
    uint8_t i = 1;
    //power and sensor id reversde for testing
    frame[i++] = power;										//eeprom_conf.sensorid;
    frame[i++] = eeprom_conf.sensortype;
    frame[i++] = eeprom_conf.sensorid;						//power;										//add send power
    frame[i++] = debug_tx_counter;                    				//add alive counter
    frame[i++] = abp2status_raw;  								//add sensor status

    Float_to_Bytearray(&frame[i], pressure);   i += 4;		//add pressure as uint32
    Float_to_Bytearray(&frame[i], temperature);i += 4;		//add temperature as uint32

    frame[0] = i-1;											//add frame length as first byte
}

static void CreateTx_EEPROMFrame(uint8_t *frame, uint8_t power, eeprom_conf_t e)
{
    uint8_t i = 1;

    frame[i++] = e.sensorid;
    frame[i++] = e.sensortype;
    frame[i++] = power;

    UINT32_to_Bytearray(&frame[i], e.storage_time_sample);			i += 4;
    UINT32_to_Bytearray(&frame[i], e.trans_time_tx);				i += 4;
    UINT32_to_Bytearray(&frame[i], e.trans_time_sample);			i += 4;
    UINT32_to_Bytearray(&frame[i], e.static_time_tx);				i += 4;
    UINT32_to_Bytearray(&frame[i], e.static_time_sample);			i += 4;


    Float_to_Bytearray(&frame[i], e.trans_press_thresh1);   		i += 4;
    Float_to_Bytearray(&frame[i], e.trans_press_thresh2);			i += 4;
    Float_to_Bytearray(&frame[i], e.trans_press_change);			i += 4;

    frame[0] = i-1;											//add frame length as first byte
}


/* USER CODE END 4 */
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
