felixd1900/TPSensor/Receiver/Software/TPReceiver/TPReceiver.ioc

Mcu.UserName=STM32L052C8Tx
PA1.GPIO_Label=RX_IRQ
PA1.Signal=GPXTI1
PA11.Signal=USB_DM
PA12.Signal=USB_DP
PA13.Signal=SYS_SWDIO
PA14.Signal=SYS_SWCLK
PA2.Signal=S_TIM21_CH1
PA4.GPIO_Label=SPI1_CS
PA4.Signal=GPIO_Output
PA5.Signal=SPI1_SCK
PA6.Signal=SPI1_MISO
PA7.Signal=SPI1_MOSI
PB12.GPIO_Label=Debug_LED
PB12.Signal=GPIO_Output
PH0-OSC_IN.Signal=RCC_OSC_IN
PH1-OSC_OUT.Signal=RCC_OSC_OUT
