felixd1900/TPSensor/TyrePressure/Software/TPSensor/Core/Inc/main.h

#define RX_IRQ_Pin GPIO_PIN_1
#define RX_IRQ_GPIO_Port GPIOA
#define RX_IRQ_EXTI_IRQn EXTI0_1_IRQn
#define RX_TX_SW_IRQ_Pin GPIO_PIN_2
#define RX_TX_SW_IRQ_GPIO_Port GPIOA
#define RX_TX_SW_IRQ_EXTI_IRQn EXTI2_3_IRQn
#define SPI1_CS_Pin GPIO_PIN_4
#define SPI1_CS_GPIO_Port GPIOA
#define Debug_LED_Pin GPIO_PIN_12
#define Debug_LED_GPIO_Port GPIOB
#define ABP2_EOC_Pin GPIO_PIN_5
#define ABP2_EOC_GPIO_Port GPIOB
