felixd1900/TPSensor/(commit log)

2025-08-17 added stm32 project
    [Pinout_Debug.xlsx]
2025-08-27 power changes
